xiaolei1998/LCHP-PM-Sensor/AndriodApp/README.md

An APP which can monitor the real-time PM values from the Arduino Machine

Android APP, ready to be deployed on phone;
