xiaolei1998/LCHP-PM-Sensor/Documents/LCHPPMS_POSTER.pdf

# Low-cost

# High-Precision

# PM Sensor

Many families are unaware of the air quality in their homes due to the high cost of a high-precision PM sensor.

Some researchers wish to build large networks of accurate PM sensors but are hindered by the cost of buying large quantities.

Our GOAL isto design and build a PM sensorthat has the same performance ofsensorsthat cost multiple times oursensor.

## How does it work?

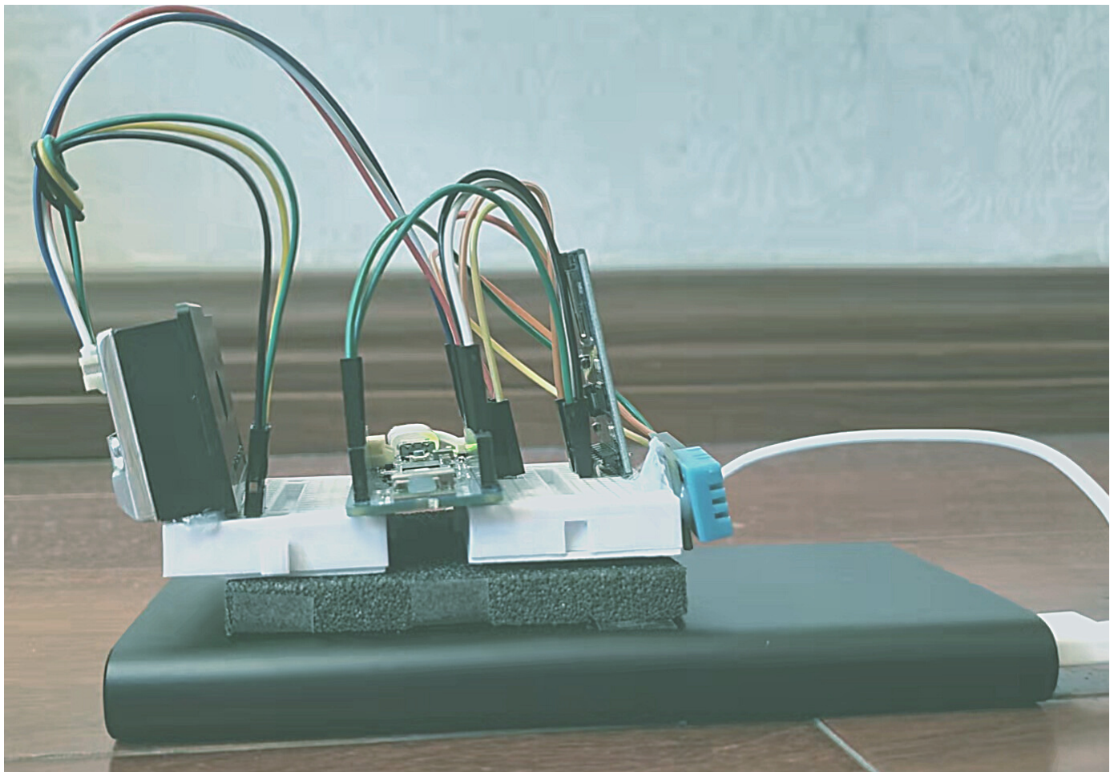
[picture p6: figure]

Download our App and connect our sensor with your phone. Now, you can view real-time PM density from our sensor or graph out historical data stored in our sensor.

## Purpose

## How to use it?

Our device uses a cheap light-scattering PM sensor together with a temperature&humidity sensor to sense data. the light-scattering sensor will output a voltage value and the value can be converted into PM density

The sensed signals will first pass through a twostage filtering algorithm to reduce short-term noise. Machine learning is then applied to the filtered signalsfor calibration.
Temperature and humidity are measured to offset the variations caused by temperature and humidity changes.

## Our expectations

Propersensing with more accurate results thancrude conversion.
Functional android application with an easy-touse graphic interface.
Wireless connection using Bluetooth and wired connection using SD card.
Long battery life

### 3 PM sensors + 1 temrpature&humidity sensor

combination to offset part-to-part and environmental variations

## Outcomes

Machine learning + filtering algorithms successfully made the sensing more accurate. The Temperature & humidity sensor also contributed to greater accuracy.

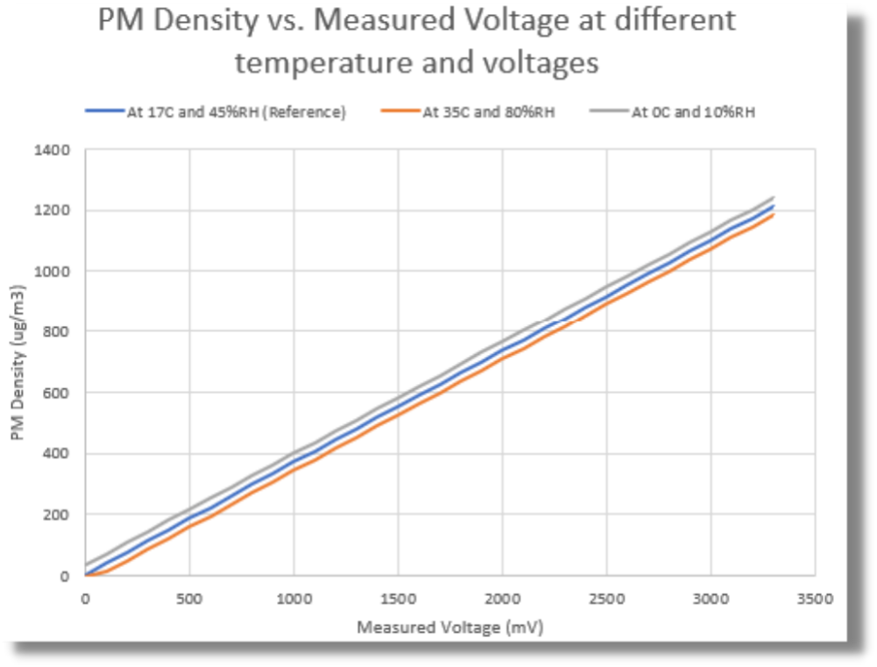
[picture p7: figure]
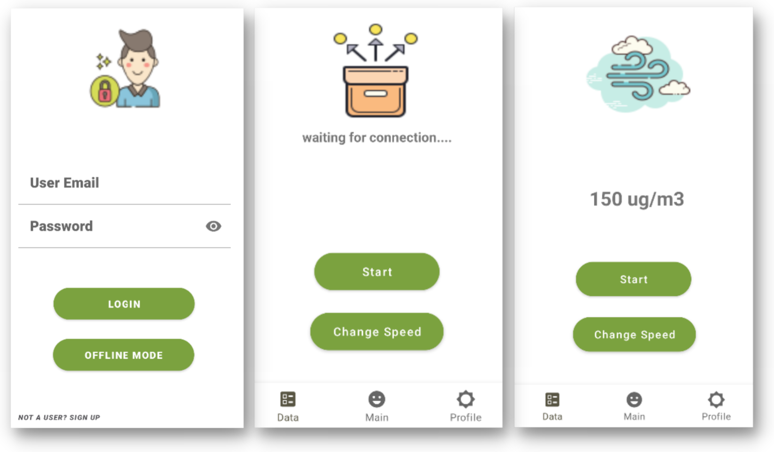
[picture p8: figure]

App isfunctional and aesthetically pleasing. Bluetooth and SD card communication were successfully implemented.
The sensor is anticipated to have a battery life over 1 month,

Only 1 PM sensor instead of 3 is used due to the limited serial UART port on our Arduino MCU.

## How we get it?

Zhaoqi MA
Xiaolei Zhang
Siru Chen, and
Zixuan Wan

The Low-cost High-Precision PM sensor is an idea from Dr.Zhenyu Zhang, developed by the 2022 ECE 492 Capstone Design team of

The product version is expected to cost less than CA$36.87

Design files and documentation are available at •https://github.com/Terry-One/LCHP-PM-Sensor •By contacting the client at zhenyu15@ualberta.ca

Technical advice courtesy of Dr.Zhenyu Zhang.
