xiaolei1998/LCHP-PM-Sensor/(commit log)

2022-02-19 Application Prototype
2022-03-22 Update PM Sensor connection and readData
2022-12-21 Update 需求文档
    update relative docs
